dongfangqing/AnionMask/README.md

# AnionMask
智能负离子口罩案例
1.规格需求
2.原理图
3.源代码
