dongfangqing/AnionMask/智能负离子口罩设计需求.pdf

# 智能负离子口罩

# 1 功能描述

## 1.1 低压驱动负离子

- 以低于正常电压驱动负离子发生器，即以 3.0V~3.2V 驱动标准 5.0V 直流负离子发生器， 减少臭氧的产生。

## 1.2 充电管理

- 配备 200mAh 3.7V 锂电池充电管理电路。Micro USB 充电，充电时侧面红色 LED 灯频闪， 充满电时灯灭。

## 1.3 开启指示

- 开关启动时正面白色 LED 灯常亮（PWM 控制）。
- 开启时检测电压电量，通过蓝牙传送到手机用户界面。
- 电量不足时白色 LED 灯频闪。

## 1.4 空气质量探测

- 通过微型空气质量传感器读取口罩盒子外侧气口的空气质量数据，通过蓝牙传送到手机 用户界面。

## 1.5 温湿度探测

- 通过微型温、湿度探测器读取口罩背面（靠近口罩盒子内侧气口）的温湿度数据，通过 蓝牙传送到手机用户界面。

# 1.6 蓝牙通讯*

- 蓝牙通讯方案：使用微信公众号硬件平台所支持的 AirSync 协议，详细请见：

## http://iot.weixin.qq.com/wiki/new/index.html?page=4-2-1

微信公众号主控页面参考：

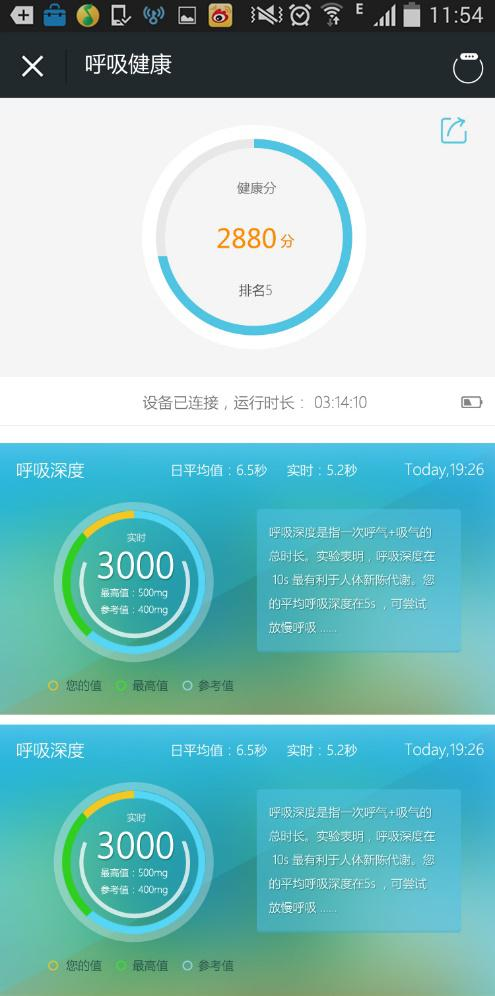
[picture p1: figure]

# 2 部件参数

## 3.1 元器件布局：

## 3.2 元器件参数：

- 侧按开关：3x6mm 贴片侧按开关

## - 电源（定制，由我司提供）：200mAh 3.7V 锂电池，尺寸：31.5X12.7X4.8mm

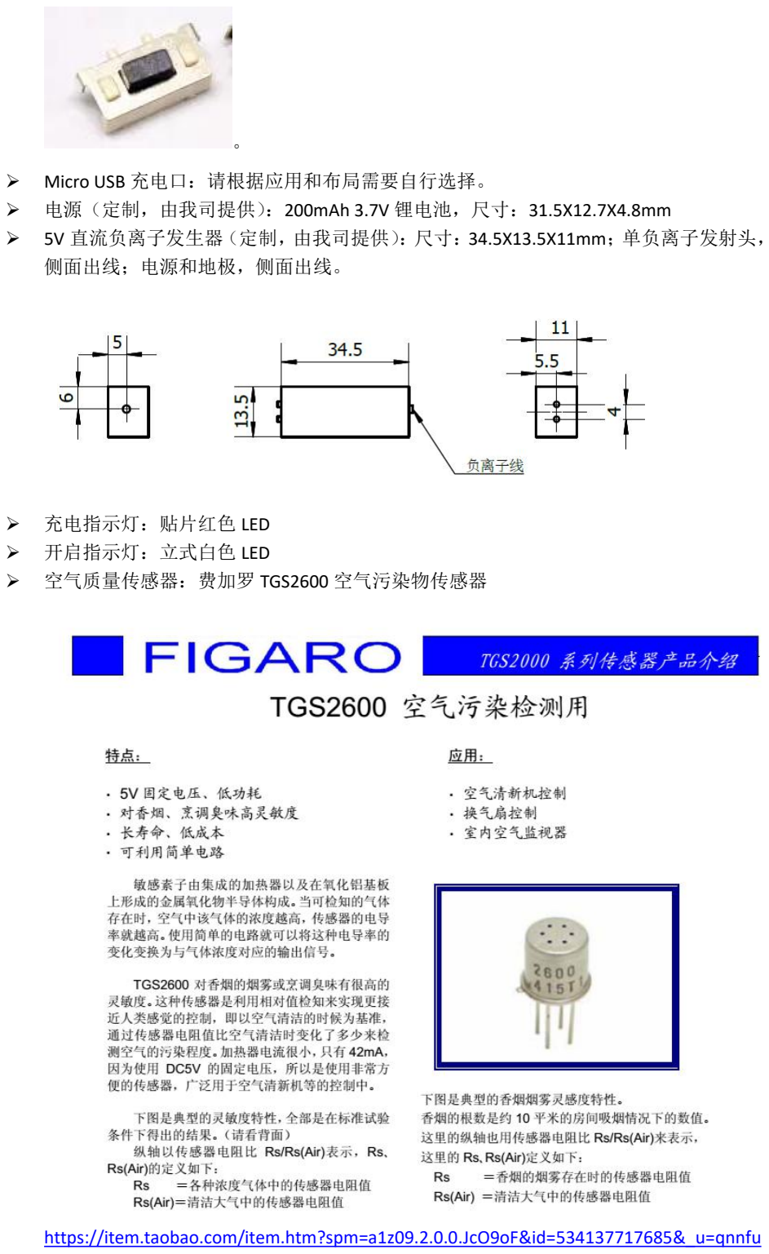
[picture p2: page 3]

。

- Micro USB 充电口：请根据应用和布局需要自行选择。
- 5V 直流负离子发生器（定制，由我司提供）：尺寸：34.5X13.5X11mm；单负离子发射头， 侧面出线；电源和地极，侧面出线。
- 充电指示灯：贴片红色 LED
- 开启指示灯：立式白色 LED
- 空气质量传感器：费加罗 TGS2600 空气污染物传感器

## https://item.taobao.com/item.htm?spm=a1z09.2.0.0.JcO9oF&id=534137717685&_u=qnnfu

d75eb (https://item.taobao.com/item.htm?spm=a1z09.2.0.0.JcO9oF&id=534137717685&_u=qnnfud75eb)
- 温湿度传感器：SHT20

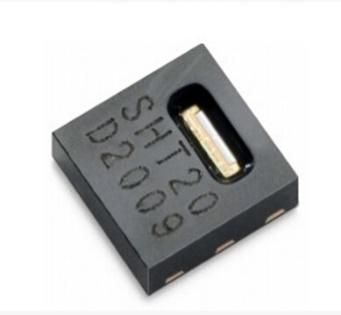
[picture p3: figure]

## https://trade.taobao.com/trade/detail/tradeSnap.htm?spm=a1z09.3.0.0.XW5xvG&trade_id

=2420030122214572
- 弹簧：直径 22mm，与 PCB 背面接地铜皮圈焊接
