dongfangqing/AnionMask/AnionMask.pdf

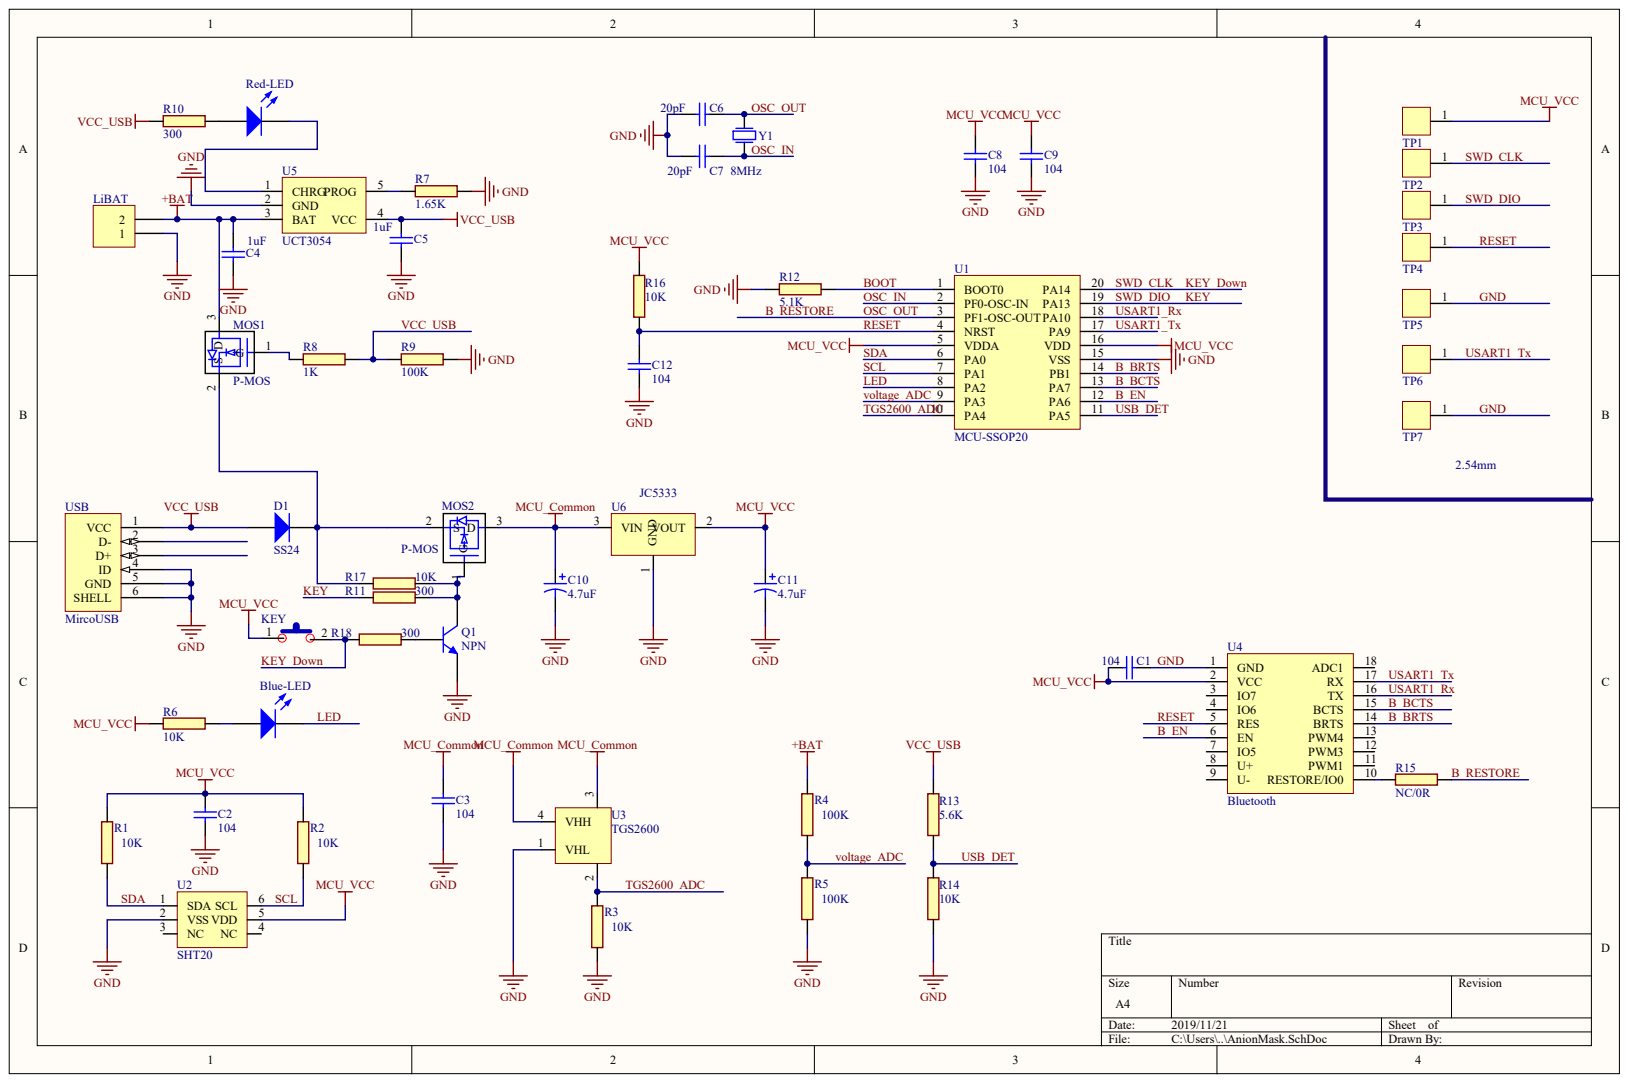
[picture p4: page 1]

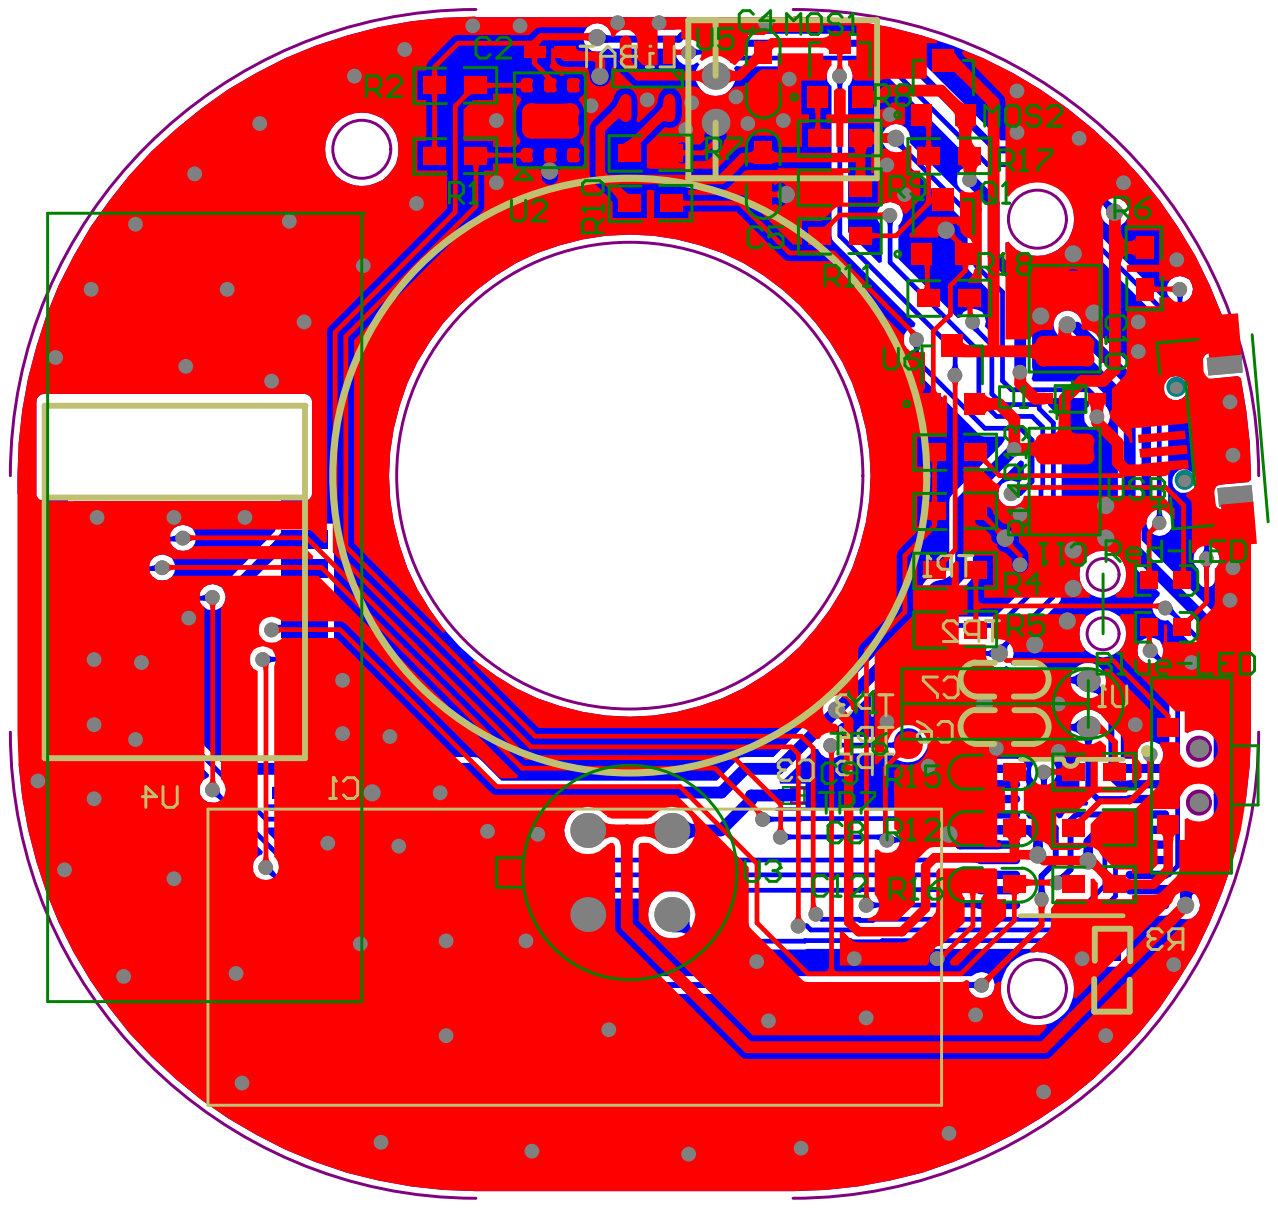
[picture p5: page 2]

Bill of Materials | <Parameter Title not found>
Source Data From: | AnionMask.PrjPcb
Project: | | AnionMask.PrjPcb
Variant: | | None
Creation Date: 2019/11/21 | 0:01:00
Print Date: | 43790 | 43790.00078
Footprint | Comment | LibRef | Designator | Description | Quantity
0603D | LED0 | LED0 | Blue-LED, Red-LED | Typical INFRARED GaAs LED-R0603 | 2
0402 | 104 | Cap | C1, C2, C3 | Resistor 0402 | 3
0603C | 1uF | Cap | C4, C5 | Capacitor | 2
0603C | 20pF | Cap | C6 | Resistor 0402 | 1
0603C | Cap | Cap | C7, C8, C9, C12 | Capacitor | 4
RB7.6-15 | 4.7uF | Cap Pol1 | C10, C11 | Polarized Capacitor (Radial) | 2
SOD323/A | SOD323/A | Diode | D1 | Default Diode | 1
key_贴片 | SW-PB1 | SW-PB1 | KEY | | 1
PH-2Y- 2.0MM-L | | Header 2 | LiBAT | Header, 2-Pin | 1
SOT23A | P-MOS | P-MOS | MOS1, MOS2 | | 2
TO-226-AA | NPN | NPN | Q1 | NPN Bipolar Transistor | 1
0603R | 10K | A02-0236 | R1, R2, R3, R6, R14, R16, R17 | Thick film resistor, SMD 0402, 1/16W, 1% | 7
0603R | 100K | A02-0236 | R4, R5, R9 | Thick film resistor, SMD 0402, 1/16W, 1% | 3
0603R | 1.65K | A02-0236 | R7 | Thick film resistor, SMD 0402, 1/16W, 1% | 1
0603R | 1K | A02-0236 | R8 | Thick film resistor, SMD 0402, 1/16W, 1% | 1
0603R | 300 | A02-0236 | R10, R11, R18 | Thick film resistor, SMD 0402, 1/16W, 1% | 3
0603R | 5.1K | A02-0236 | R12 | Thick film resistor, SMD 0402, 1/16W, 1% | 1
0603R | 5.6K | A02-0236 | R13 | Thick film resistor, SMD 0402, 1/16W, 1% | 1
0603R | NC/0R | A02-0236 | R15 | Thick film resistor, SMD 0402, 1/16W, 1% | 1
TP | HDR1 | HDR1 | TP1, TP2, TP3, TP4, TP5, TP6, TP7 | | 7
TSSOP20 | MCU-SSOP20 | STM32F030x4-
| | SSOP20 | U1 | | 1
| SHT20 | SHT20 | U2 | | 1
| TGS2600 | TGS2600 | U3 | | 1
bluetooth | Bluetooth | Bluetooth | U4 | | 1
SOT-23-5 | UCT3054 | UCT3054 | U5 | | 1
SOT23 | JC5333 | JC5333 | U6 | | 1
MICRO-USB | MircoUSB | USB-MINI-typeB
| | connector | USB | USB-MINI-typeB connector | 1
CRY- 32.768KHz | 8MHz | CRY | Y1 | | 1
| | | | | 53
Approved | | Notes
