dongfangqing/AnionMask/user/I2C/i2c_driver.h

#ifndef _I2C_DRIVER_H_
#define _I2C_DRIVER_H_

#include "stm32f0xx.h"
#include <inttypes.h>

#define I2C_WR	0		/* 写控制bit */
#define I2C_RD	1		/* 读控制bit */

#define GPIO_PORT_I2C	GPIOB			/* GPIO端口 */
#define RCC_I2C_PORT 	RCC_AHBPeriph_GPIOB		/* GPIO端口时钟 */
#define I2C_SCL_PIN		GPIO_Pin_6			/* 连接到SCL时钟线的GPIO */
#define I2C_SDA_PIN		GPIO_Pin_7			/* 连接到SDA数据线的GPIO */


#if 1	/* 条件编译： 1 选择GPIO的库函数实现IO读写 */
	#define I2C_SCL_1()  GPIO_SetBits(GPIO_PORT_I2C, I2C_SCL_PIN)		/* SCL = 1 */
	#define I2C_SCL_0()  GPIO_ResetBits(GPIO_PORT_I2C, I2C_SCL_PIN)		/* SCL = 0 */
	
	#define I2C_SDA_1()  GPIO_SetBits(GPIO_PORT_I2C, I2C_SDA_PIN)		/* SDA = 1 */
	#define I2C_SDA_0()  GPIO_ResetBits(GPIO_PORT_I2C, I2C_SDA_PIN)		/* SDA = 0 */
	
	#define I2C_SDA_READ()  GPIO_ReadInputDataBit(GPIO_PORT_I2C, I2C_SDA_PIN)	/* 读SDA口线状态 */
	#define I2C_SCL_READ()  GPIO_ReadInputDataBit(GPIO_PORT_I2C, I2C_SCL_PIN)	/* 读SCL口线状态 */
#else	/* 这个分支选择直接寄存器操作实现IO读写 */
    /*　注意：如下写法，在IAR最高级别优化时，会被编译器错误优化 */
	#define I2C_SCL_1()  GPIO_PORT_I2C->BSRR = I2C_SCL_PIN				/* SCL = 1 */
	#define I2C_SCL_0()  GPIO_PORT_I2C->BRR = I2C_SCL_PIN				/* SCL = 0 */
	
	#define I2C_SDA_1()  GPIO_PORT_I2C->BSRR = I2C_SDA_PIN				/* SDA = 1 */
	#define I2C_SDA_0()  GPIO_PORT_I2C->BRR = I2C_SDA_PIN				/* SDA = 0 */
	
	#define I2C_SDA_READ()  ((GPIO_PORT_I2C->IDR & I2C_SDA_PIN) != 0)	/* 读SDA口线状态 */
#endif

typedef uint8_t u8;

void I2C_GPIOInitConfig(void);
void I2C_Start(void);
void I2C_Stop(void);
void I2C_SendACK(u8 ack);
u8 I2C_RecvACK(void);

void I2C_SendByte(u8 dat);
u8 I2C_RecvByte(void);


uint8_t I2C_CheckDevice(uint8_t _Address);

void SCL_IN(void);
void SCL_OUT(void);


#endif
