dongfangqing/AnionMask/user/OLED_Device/OLED_Device.c

#include "OLED_Device.h"
#include "SPI_Device.h"
#include "SysTick.h"

/*********************************************************************************************
*******************************************引脚定义*******************************************
**SCLK(SCL)----->GPIOB13
**MOSI(SDA)----->GPIOB15
**RESET--------->GPIOF4
**D/C----------->GPIOF5
**********************************************************************************************/

#define OLED_RESET_LOW()		GPIO_ResetBits(GPIOF, GPIO_Pin_4)	//低电平复位
#define OLED_RESET_HIGH()		GPIO_SetBits(GPIOF, GPIO_Pin_4)

#define OLED_CMD_MODE()			GPIO_ResetBits(GPIOF, GPIO_Pin_5)		//命令模式
#define OLED_DATA_MODE()		GPIO_SetBits(GPIOF, GPIO_Pin_5)			//数据模式

#define X_WIDTH 128
#define Y_WIDTH 64


const unsigned char F6x8[][6] =
{
    { 0x00, 0x00, 0x00, 0x00, 0x00, 0x00 },   // sp
    { 0x00, 0x00, 0x00, 0x2f, 0x00, 0x00 },   // !
    { 0x00, 0x00, 0x07, 0x00, 0x07, 0x00 },   // "
    { 0x00, 0x14, 0x7f, 0x14, 0x7f, 0x14 },   // #
    { 0x00, 0x24, 0x2a, 0x7f, 0x2a, 0x12 },   // $
    { 0x00, 0x62, 0x64, 0x08, 0x13, 0x23 },   // %
    { 0x00, 0x36, 0x49, 0x55, 0x22, 0x50 },   // &
    { 0x00, 0x00, 0x05, 0x03, 0x00, 0x00 },   // '
    { 0x00, 0x00, 0x1c, 0x22, 0x41, 0x00 },   // (
    { 0x00, 0x00, 0x41, 0x22, 0x1c, 0x00 },   // )
    { 0x00, 0x14, 0x08, 0x3E, 0x08, 0x14 },   // *
    { 0x00, 0x08, 0x08, 0x3E, 0x08, 0x08 },   // +
    { 0x00, 0x00, 0x00, 0xA0, 0x60, 0x00 },   // ,
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
{
#ifdef DEVICE_OLED
	OLED_CMD_MODE();
	SPI_WriterByte(cmd);
#endif
}

/********************************************************************
**函数功能：OLED延时函数
*********************************************************************/
void LCD_DLY_ms(unsigned int ms)
{
	delay_ms(ms);
}

/********************************************************************
**函数功能：OLED复位
*********************************************************************/
void LCD_Reset(void)
{
	OLED_RESET_LOW();
	LCD_DLY_ms(50);
	OLED_RESET_HIGH();
}


void LCD_Set_Pos(unsigned char x, unsigned char y)
{ 
	LCD_WrCmd(0xb0+y);
	LCD_WrCmd(((x&0xf0)>>4)|0x10);
	LCD_WrCmd((x&0x0f)|0x00); 
}




void LCD_Fill(unsigned char bmp_dat)
{
	unsigned char y,x;

	for(y=0;y<8;y++)
	{
		LCD_WrCmd(0xb0+y);
		LCD_WrCmd(0x01);
		LCD_WrCmd(0x10);
		for(x=0;x<X_WIDTH;x++)
			LCD_WrDat(bmp_dat);
	}
}



void LCD_CLS(void)
{
	unsigned char y,x;
	
	for(y=0;y<8;y++)
	{
		LCD_WrCmd(0xb0+y);
		LCD_WrCmd(0x01);
		LCD_WrCmd(0x10); 
		for(x=0;x<X_WIDTH;x++)
			LCD_WrDat(0);
	}
}



void LCD_Init(void)        
{
	OLED_GPIO_InitConfig();
	
//	LCD_SCL=1;
	LCD_Reset();

	//从上电到下面开始初始化要有足够的时间，即等待RC复位完毕   

	LCD_WrCmd(0xae);//--turn off oled panel
	LCD_WrCmd(0x00);//---set low column address
	LCD_WrCmd(0x10);//---set high column address
	LCD_WrCmd(0x40);//--set start line address  Set Mapping RAM Display Start Line (0x00~0x3F)
	LCD_WrCmd(0x81);//--set contrast control register
	LCD_WrCmd(0xcf); // Set SEG Output Current Brightness
	LCD_WrCmd(0xa1);//--Set SEG/Column Mapping     0xa0左右反置 0xa1正常
	LCD_WrCmd(0xc8);//Set COM/Row Scan Direction   0xc0上下反置 0xc8正常
	LCD_WrCmd(0xa6);//--set normal display
	LCD_WrCmd(0xa8);//--set multiplex ratio(1 to 64)
	LCD_WrCmd(0x3f);//--1/64 duty
	LCD_WrCmd(0xd3);//-set display offset	Shift Mapping RAM Counter (0x00~0x3F)
	LCD_WrCmd(0x00);//-not offset
	LCD_WrCmd(0xd5);//--set display clock divide ratio/oscillator frequency
	LCD_WrCmd(0x80);//--set divide ratio, Set Clock as 100 Frames/Sec
	LCD_WrCmd(0xd9);//--set pre-charge period
	LCD_WrCmd(0xf1);//Set Pre-Charge as 15 Clocks & Discharge as 1 Clock
	LCD_WrCmd(0xda);//--set com pins hardware configuration
	LCD_WrCmd(0x12);
	LCD_WrCmd(0xdb);//--set vcomh
	LCD_WrCmd(0x40);//Set VCOM Deselect Level
	LCD_WrCmd(0x20);//-Set Page Addressing Mode (0x00/0x01/0x02)
	LCD_WrCmd(0x02);//
	LCD_WrCmd(0x8d);//--set Charge Pump enable/disable
	LCD_WrCmd(0x14);//--set(0x10) disable
	LCD_WrCmd(0xa4);// Disable Entire Display On (0xa4/0xa5)
	LCD_WrCmd(0xa6);// Disable Inverse Display On (0xa6/a7) 
	LCD_WrCmd(0xaf);//--turn on oled panel
	LCD_Fill(0x00);  //初始清屏
	LCD_Set_Pos(0,0); 	
}


//==============================================================
//函数名：LCD_P6x8Str(unsigned char x,unsigned char y,unsigned char *p)
//功能描述：写入一组标准ASCII字符串
//参数：显示的位置（x,y），y为页范围0～7，要显示的字符串
//返回：无
//==============================================================  
void LCD_P6x8Str(unsigned char x,unsigned char y,unsigned char ch[])
{
	unsigned char c=0,i=0,j=0;
	
	while (ch[j]!='\0')
	{    
		c =ch[j]-32;
		if(x>126){x=0;y++;}
			LCD_Set_Pos(x,y);
		
		for(i=0;i<6;i++)
			LCD_WrDat(F6x8[c][i]);
		
		x+=6;
		j++;
	}
}

//==============================================================
//函数名：LCD_P8x16Str(unsigned char x,unsigned char y,unsigned char *p)
//功能描述：写入一组标准ASCII字符串
//参数：显示的位置（x,y），y为页范围0～7，要显示的字符串
//返回：无
//============================================================== 
 
void LCD_P8x16Str(unsigned char x,unsigned char y,unsigned char ch[])
{
	unsigned char c=0,i=0,j=0;

	while (ch[j]!='\0')
	{    
		c =ch[j]-32;
		if(x>120){x=0;y++;}
			LCD_Set_Pos(x,y);
		
		for(i=0;i<8;i++)     
			LCD_WrDat(F8X16[c*16+i]);
		
		LCD_Set_Pos(x,y+1);
		
		for(i=0;i<8;i++)     
			LCD_WrDat(F8X16[c*16+i+8]);
		
		x+=8;
		j++;
	}
}
