dongfangqing/AnionMask/user/LowPower/LowPower.c

#include "LowPower.h"
#include "stm32f0xx.h"
#include "usart_device.h"
#include "power_ctl.h"
#include "Led_Device.h"




static void Exti0_InitConfig(void)
{
	EXTI_InitTypeDef EXTI_InitStruct;
	NVIC_InitTypeDef NVIC_InitStruct;
	
	/* Enable SYSCFG clock */
	RCC_APB2PeriphClockCmd(RCC_APB2Periph_SYSCFG, ENABLE);
	/* Connect EXTI0 Line to PA0 pin */
	SYSCFG_EXTILineConfig(EXTI_PortSourceGPIOA, EXTI_PinSource0);
	
	EXTI_InitStruct.EXTI_Line = EXTI_Line0;
	EXTI_InitStruct.EXTI_Mode = EXTI_Mode_Interrupt;
	EXTI_InitStruct.EXTI_Trigger = EXTI_Trigger_Falling;
	EXTI_InitStruct.EXTI_LineCmd = ENABLE;
	EXTI_Init(&EXTI_InitStruct);
	
	NVIC_InitStruct.NVIC_IRQChannel = EXTI0_1_IRQn;
	NVIC_InitStruct.NVIC_IRQChannelPriority = 0;
	NVIC_InitStruct.NVIC_IRQChannelCmd = ENABLE;
	NVIC_Init(&NVIC_InitStruct);
}

static void LowPower_Setup_GPIO(void)
{
	GPIO_InitTypeDef GPIO_InitStructure;
	RCC_AHBPeriphClockCmd(RCC_AHBPeriph_GPIOA, ENABLE);
	RCC_AHBPeriphClockCmd(RCC_AHBPeriph_GPIOB, ENABLE);
	RCC_AHBPeriphClockCmd(RCC_AHBPeriph_GPIOF, ENABLE);
	
	GPIO_InitStructure.GPIO_Pin =  GPIO_Pin_All;
	GPIO_InitStructure.GPIO_Mode = GPIO_Mode_IN;
	GPIO_InitStructure.GPIO_PuPd = GPIO_PuPd_NOPULL;
	GPIO_Init(GPIOA, &GPIO_InitStructure);
	
	GPIO_InitStructure.GPIO_Pin =  GPIO_Pin_0|GPIO_Pin_1|GPIO_Pin_3|
						GPIO_Pin_4|GPIO_Pin_5|GPIO_Pin_6|GPIO_Pin_7;
	GPIO_InitStructure.GPIO_Mode = GPIO_Mode_IN;
	GPIO_InitStructure.GPIO_PuPd = GPIO_PuPd_NOPULL;
	GPIO_Init(GPIOB, &GPIO_InitStructure);
	
	GPIO_InitStructure.GPIO_Pin =  GPIO_Pin_0|GPIO_Pin_1;
	GPIO_InitStructure.GPIO_Mode = GPIO_Mode_IN;
	GPIO_InitStructure.GPIO_PuPd = GPIO_PuPd_NOPULL;
	GPIO_Init(GPIOF, &GPIO_InitStructure);
	
//	RCC_AHBPeriphClockCmd(RCC_AHBPeriph_GPIOA, DISABLE);
//	RCC_AHBPeriphClockCmd(RCC_AHBPeriph_GPIOB, DISABLE);
//	RCC_AHBPeriphClockCmd(RCC_AHBPeriph_GPIOF, DISABLE);
}

extern void AnionMask_Power_off(void);
void In_Stop_Mode(void)
{
	LED(OFF);
	Anion_Power_ctl(OFF);
	TGS2600_Power_ctl(OFF);
	AIRclean_Power_ctl(OFF);
	LowPower_Setup_GPIO();
	RCC_APB1PeriphClockCmd(RCC_APB1Periph_PWR, ENABLE); 
	NVIC_SystemLPConfig(NVIC_LP_SLEEPDEEP,ENABLE);
	Exti0_InitConfig();
	AnionMask_Power_off();
	PWR_EnterSTOPMode(PWR_Regulator_LowPower, PWR_STOPEntry_WFI);
		
}


void In_Sleep_Mode(void)
{
}
