dongfangqing/AnionMask/user/power_ctl/power_ctl.c

#include "power_ctl.h"


//负离子电源控制初始化
static void Anion_Power_Init(void)
{
	GPIO_InitTypeDef GPIO_InitStructure;
	
	RCC_AHBPeriphClockCmd(RCC_AHBPeriph_GPIOA, ENABLE);
	
	GPIO_InitStructure.GPIO_Pin = GPIO_Pin_1;
	GPIO_InitStructure.GPIO_Mode = GPIO_Mode_OUT;
	GPIO_InitStructure.GPIO_OType = GPIO_OType_PP;
	GPIO_InitStructure.GPIO_PuPd = GPIO_PuPd_UP;
	GPIO_InitStructure.GPIO_Speed = GPIO_Speed_50MHz;
	GPIO_Init(GPIOA, &GPIO_InitStructure);
	
	GPIO_SetBits(GPIOA,GPIO_Pin_1);
}


//TGS2600电源控制初始化
static void TGS2600_Power_Init(void)
{
	GPIO_InitTypeDef GPIO_InitStructure;
	
	RCC_AHBPeriphClockCmd(RCC_AHBPeriph_GPIOA, ENABLE);
	
	GPIO_InitStructure.GPIO_Pin = GPIO_Pin_8;
	GPIO_InitStructure.GPIO_Mode = GPIO_Mode_OUT;
	GPIO_InitStructure.GPIO_OType = GPIO_OType_PP;
	GPIO_InitStructure.GPIO_PuPd = GPIO_PuPd_UP;
	GPIO_InitStructure.GPIO_Speed = GPIO_Speed_50MHz;
	GPIO_Init(GPIOA, &GPIO_InitStructure);
	
	GPIO_SetBits(GPIOA,GPIO_Pin_8);
}


void power_ctl_InitConfig(void)
{
	Anion_Power_Init();
	TGS2600_Power_Init();
}

void Anion_Power_ctl(uint8_t status)
{
	if(status)
	{
		GPIO_SetBits(GPIOA,GPIO_Pin_1);
	}
	else
	{
		GPIO_ResetBits(GPIOA,GPIO_Pin_1);
	}
}



void TGS2600_Power_ctl(uint8_t status)
{
	if(status)
	{
		GPIO_SetBits(GPIOA,GPIO_Pin_8);
	}
	else
	{
		GPIO_ResetBits(GPIOA,GPIO_Pin_8);
	}
}

void AIRclean_Power_ctl(uint8_t status)
{
	if(status)
	{
		GPIO_SetBits(GPIOA,GPIO_Pin_1);
	}
	else
	{
		GPIO_ResetBits(GPIOA,GPIO_Pin_1);
	}
}
